freazert/prototyping/second version/schetsen/Eerste schets.jpg

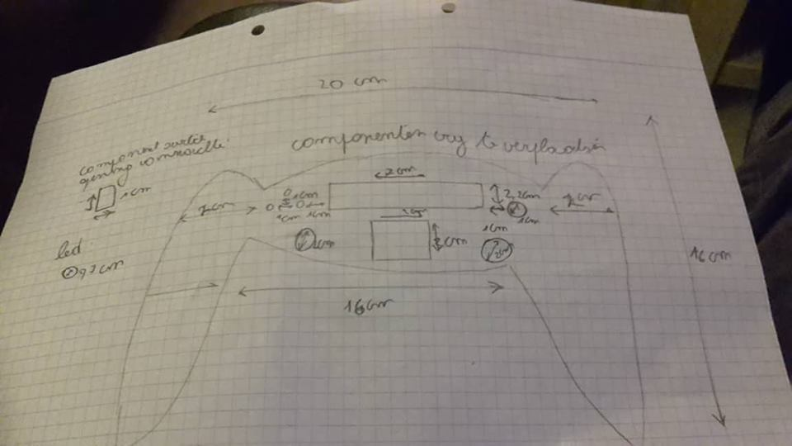
second version/schetsen/Eerste schets.jpg
