freazert/prototyping/first version/schetsen/Opmeting componenten.jpg

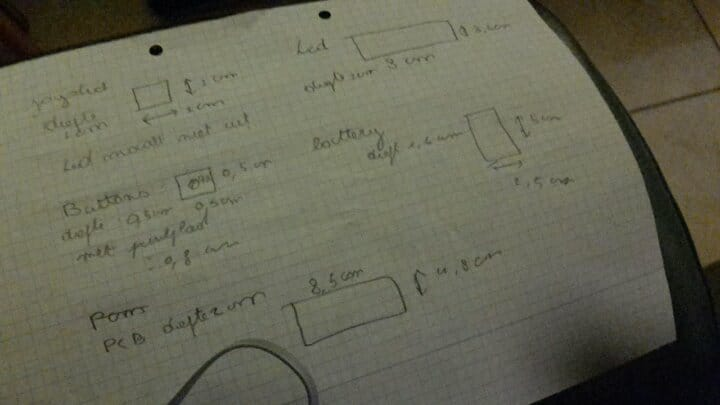
first version/schetsen/Opmeting componenten.jpg
