freazert/prototyping/first version/OpenScad/3D printen/Robot arm/Arm.stl

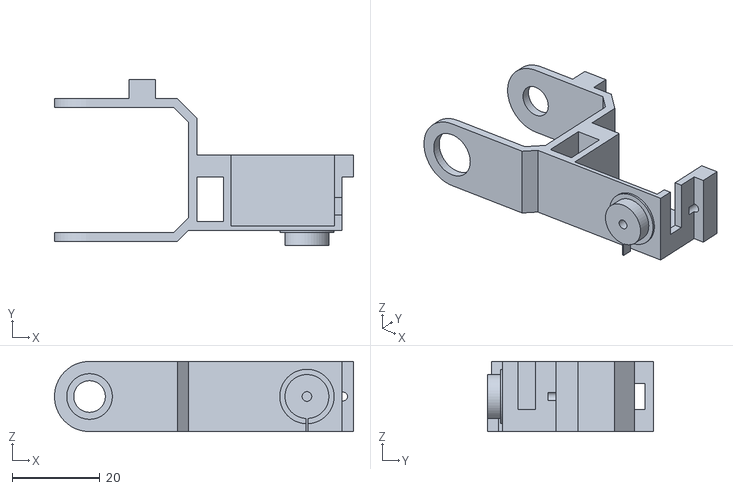
[picture p26: CAD file, 2018-10-17]
first version/OpenScad/3D printen/Robot arm/Arm.stl
68.1 x 37.9 x 16.0
