freazert/prototyping/first version/OpenScad/Lasercutting/metal/lasercutten2.dxf

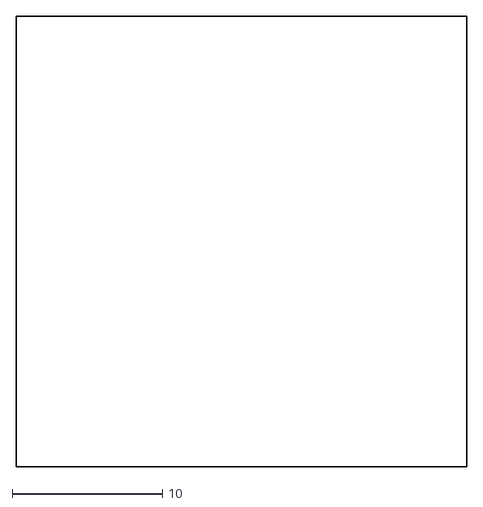
[picture p27: CAD file, 2018-10-17]
first version/OpenScad/Lasercutting/metal/lasercutten2.dxf
30.0 x 30.0
