freazert/prototyping/first version/OpenScad/Lasercutting/plexi/lasercutten2.dxf

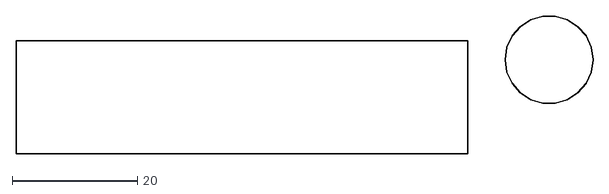
[picture p28: CAD file, 2018-10-17]
first version/OpenScad/Lasercutting/plexi/lasercutten2.dxf
92.0 x 21.9
