freazert/prototyping/first version/OpenScad/3D printen/Robot arm/ArmSpring.stl

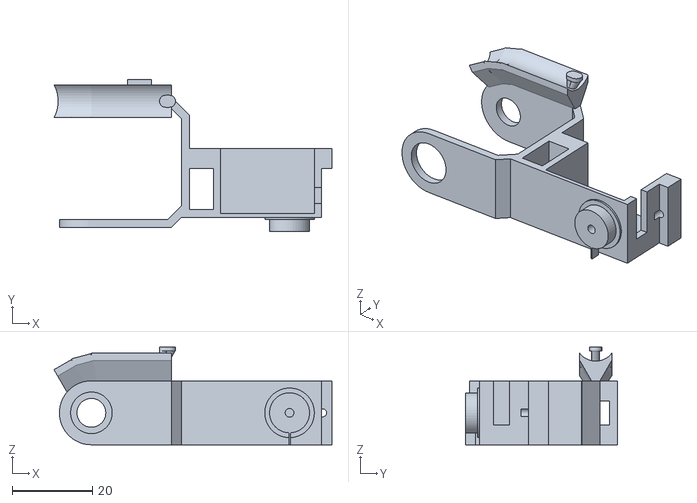
[picture p29: CAD file, 2018-10-17]
first version/OpenScad/3D printen/Robot arm/ArmSpring.stl
69.4 x 37.9 x 24.4
