freazert/prototyping/first version/OpenScad/Lasercutting/metal/lasercutten.dxf

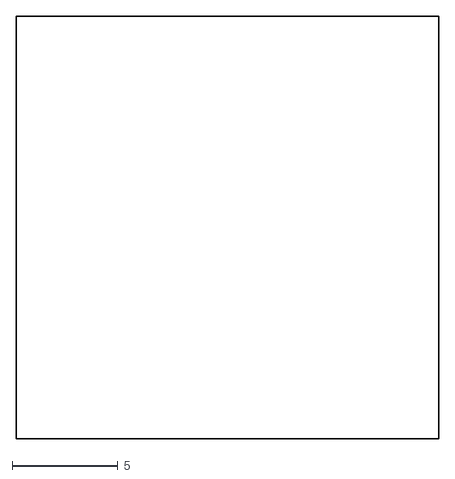
[picture p30: CAD file, 2018-10-17]
first version/OpenScad/Lasercutting/metal/lasercutten.dxf
20.0 x 20.0
