freazert/prototyping/first version/OpenScad/3D printen/Robot arm/GripperGear.stl

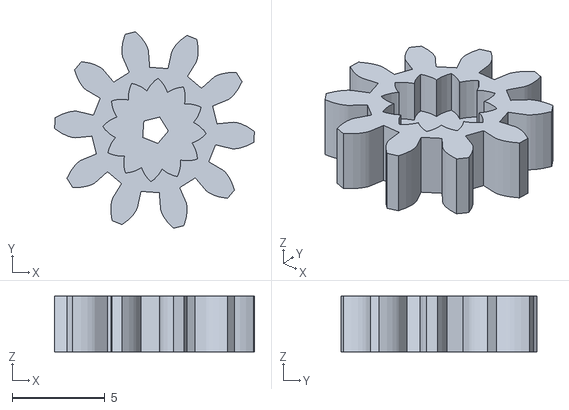
[picture p31: CAD file, 2018-10-17]
first version/OpenScad/3D printen/Robot arm/GripperGear.stl
10.8 x 10.6 x 3.00
