freazert/prototyping/first version/OpenScad/3D printen/Robot arm/GripperRack.stl

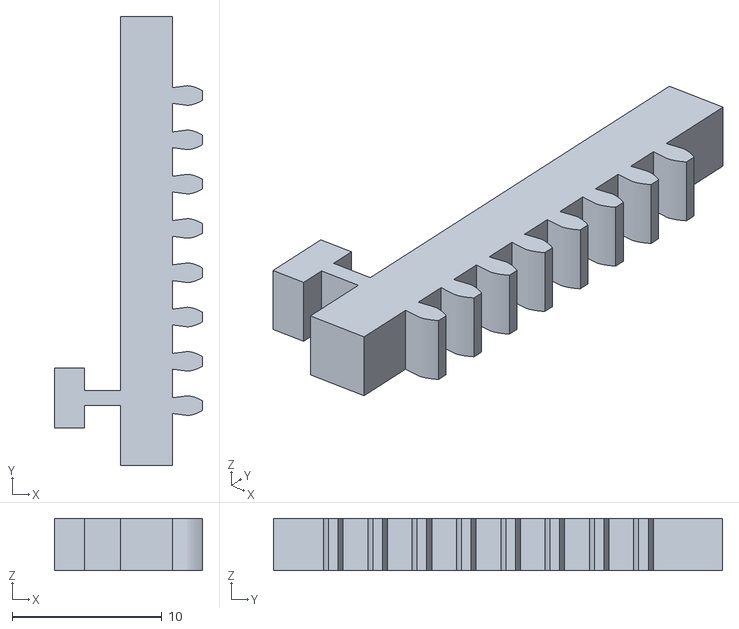
[picture p32: CAD file, 2018-10-17]
first version/OpenScad/3D printen/Robot arm/GripperRack.stl
9.89 x 30.0 x 3.50
