freazert/prototyping/first version/OpenScad/3D printen/Robot arm/Foot.stl

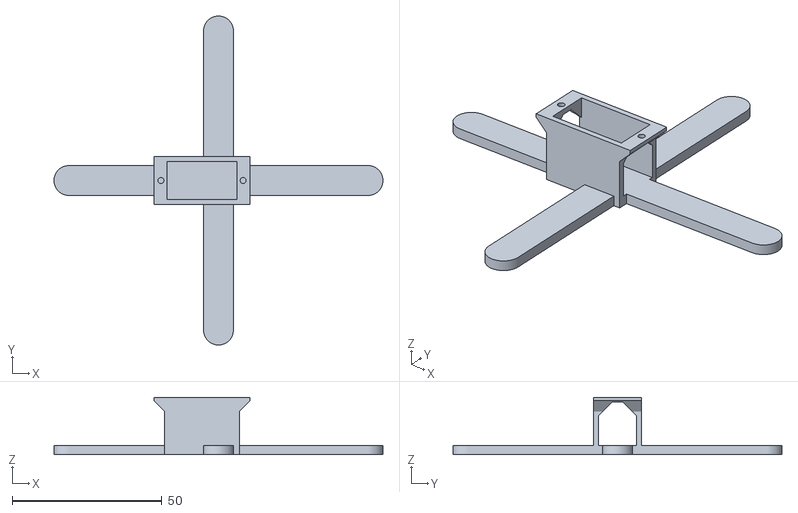
[picture p33: CAD file, 2018-10-17]
first version/OpenScad/3D printen/Robot arm/Foot.stl
110.0 x 110.0 x 19.2
