freazert/prototyping/first version/OpenScad/3D printen/Robot arm/Gripper.stl

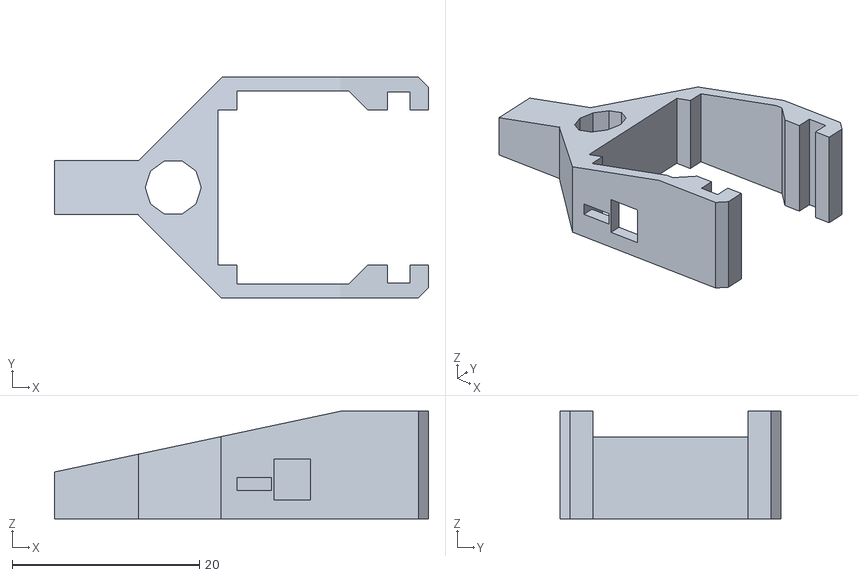
[picture p34: CAD file, 2018-10-17]
first version/OpenScad/3D printen/Robot arm/Gripper.stl
40.0 x 23.6 x 11.5
