freazert/prototyping/first version/OpenScad/3D printen/Robot arm/ArmFront.stl

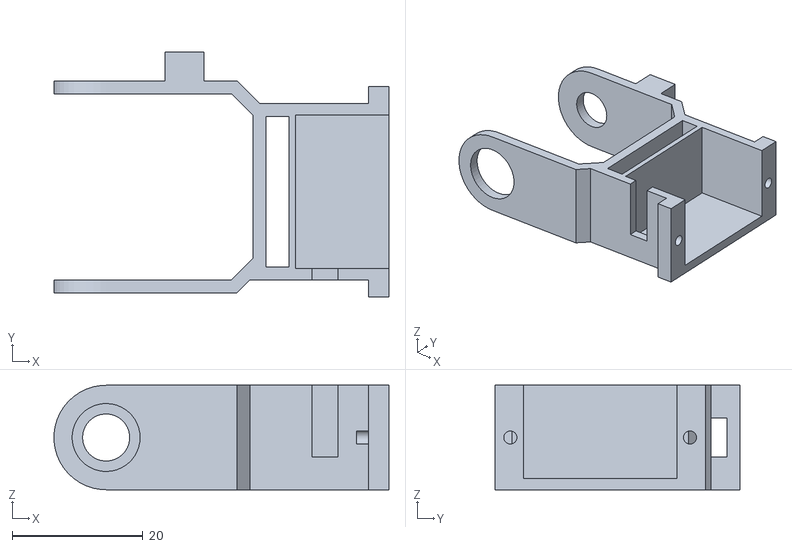
[picture p35: CAD file, 2018-10-17]
first version/OpenScad/3D printen/Robot arm/ArmFront.stl
51.3 x 37.5 x 16.0
