freazert/prototyping/first version/OpenScad/3D printen/Robot arm/FrontPlate.stl

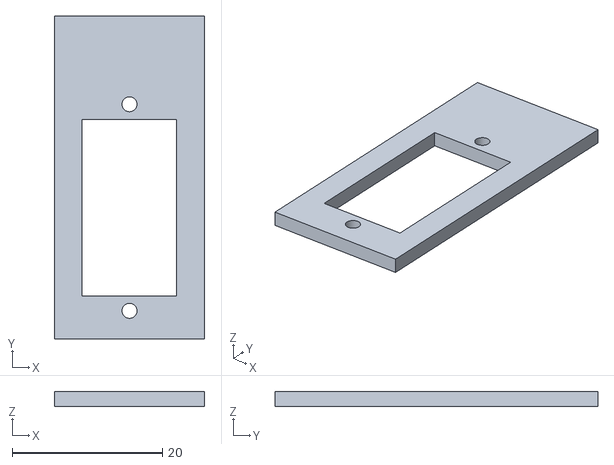
[picture p36: CAD file, 2018-10-17]
first version/OpenScad/3D printen/Robot arm/FrontPlate.stl
20.0 x 43.0 x 2.00
