freazert/prototyping/first version/OpenScad/3D printen/Robot arm/Swing.stl

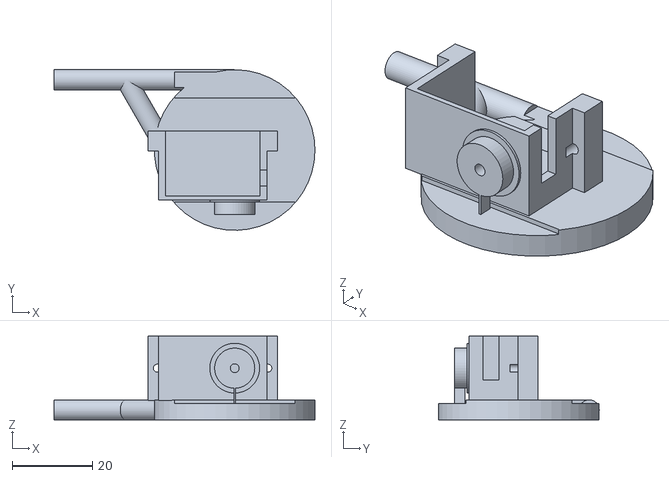
[picture p37: CAD file, 2018-10-17]
first version/OpenScad/3D printen/Robot arm/Swing.stl
65.0 x 40.0 x 20.9
