freazert/prototyping/first version/OpenScad/Lasercutting/lasercutten.scad

square([80,22]);

translate([100,15])

circle(10);

translate([130,2])
square([30,30]);
