freazert/prototyping/first version/Eagle/Robot arm.brd

## EAGLE design first version/Eagle/Robot arm.brd (2018-10-17)

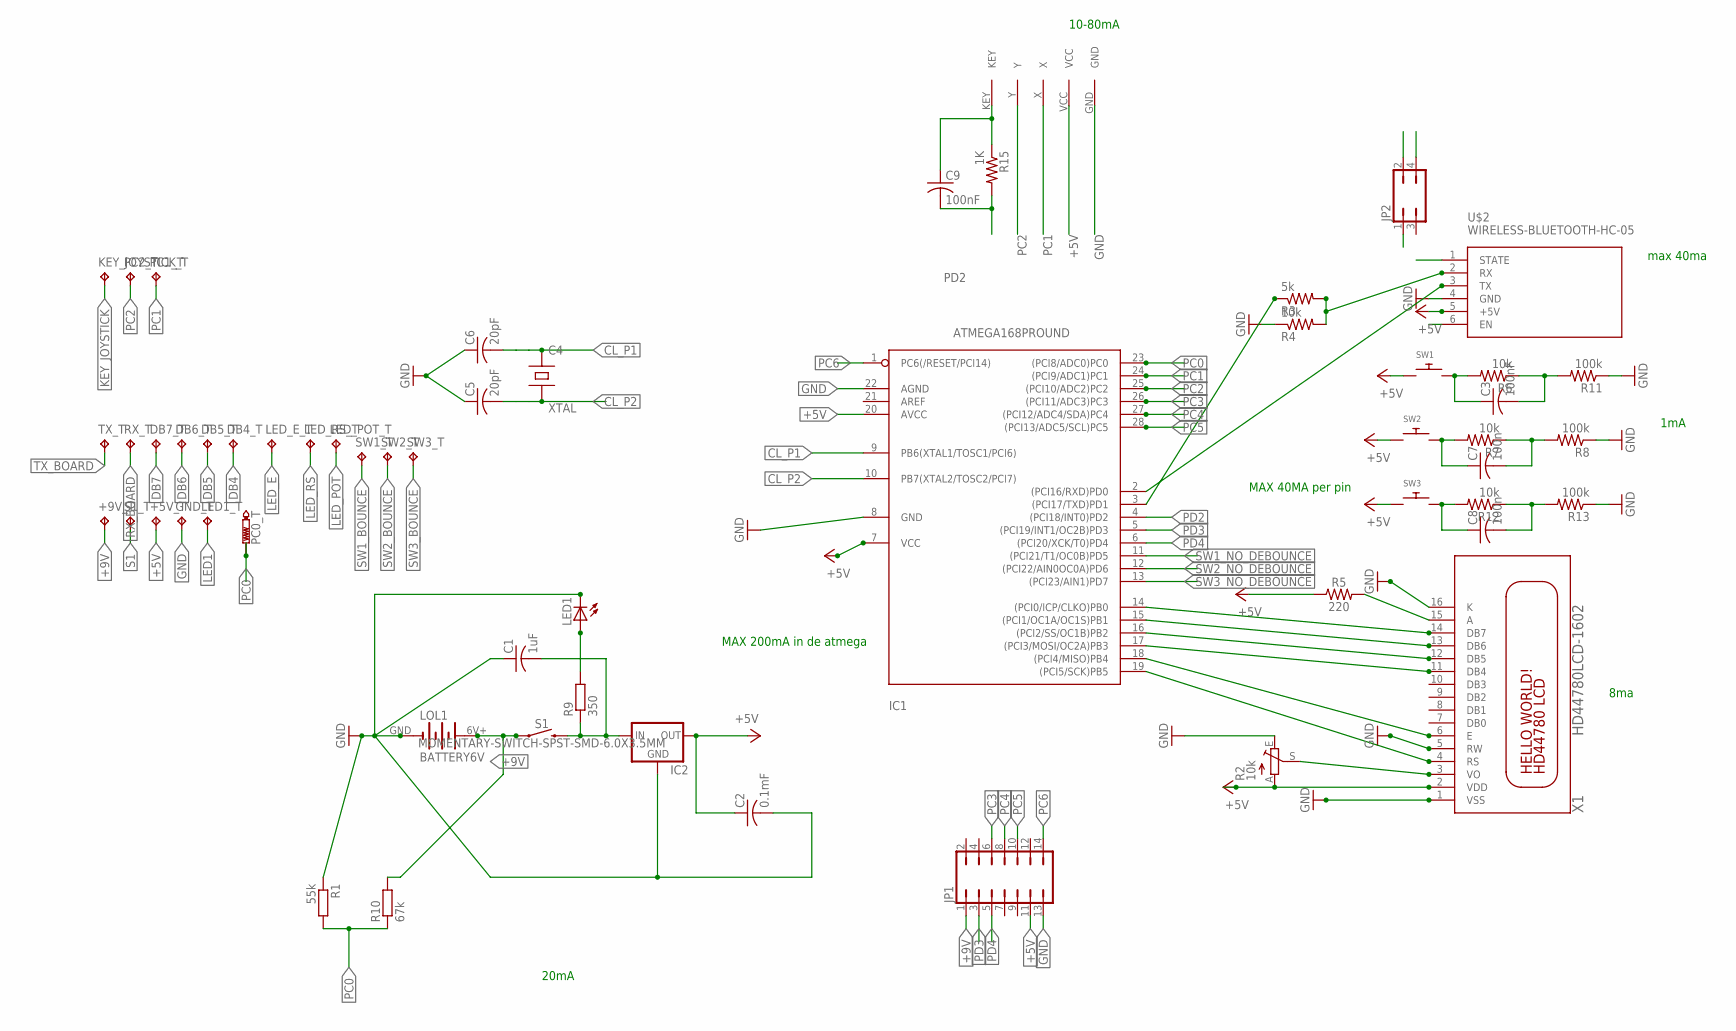
[picture p38: schematic Robot arm.sch]

Parts:
+5V_T, +9V_T: TPB1,27; B1,27
C1: 1uF; C025-025X050
C2: 0.1mF; C025-025X050
C3, C9: 100nF; C025-025X050
C4: XTAL; HC49UP
C5, C6: 20pF; C025-025X050
C7, C8: 100n; C025-025X050
DB4_T, DB5_T, DB6_T, DB7_T: TPB1,27; B1,27
GND_T: TPB1,27; B1,27
IC1: ATMEGA168PROUND; DIL28-3-ROUND
IC2: MCP1700INLINE; TO92-INLINE
JP1: JP7Q
JP2: JP2Q
KEY_JOYSTICK_T: TPB1,27; B1,27
LED1: LED_E; LED_1206
LED1_T: TPB1,27; B1,27
LED_E_T: TPB1,27; B1,27
LED_POT_T: TPB1,27; B1,27
LED_RS_T: TPB1,27; B1,27
LOL1: BATTERY6V; BATTERY6PACK
PC0_T: PTR1B1,27; B1,27
PC1_T, PC2_T: TPB1,27; B1,27
R1: 55k; R0805
R2: 10k; B25V
R3: 5k; 0204/5
R4, R6, R7, R12: 10k; 0204/5
R5: 220; 0603
R8, R11, R13: 100k; 0204/5
R9: 350; R0805
R10: 67k; R0805
R15: 1K; 0204/5
RX_T: TPB1,27; B1,27
S1: MOMENTARY-SWITCH-SPST-SMD-6.0X3.5MM; TACTILE_SWITCH_SMD_6.0X3.5MM
S1_T: TPB1,27; B1,27
SW1, SW2, SW3: SWITCH_PUSHBUTTONSOFTTOUCHSMD_SJ; PUSHBUTTON_SMD_SJ
SW1_T, SW2_T, SW3_T: TPB1,27; B1,27
TX_T: TPB1,27; B1,27
U$1: JOYSTICK
U$2: WIRELESS-BLUETOOTH-HC-05
X1: HD44780LCD-1602; LCD1602

Connections:
+5V: +5V_T.TP, C2.1, IC1.7 (VCC), IC1.20 (AVCC), IC2.3 (OUT), JP1.11, R2.A, R5.1, SW1.P$1, SW2.P$1, SW3.P$1, U$1.VCC, U$2.5 (+5V), X1.2 (VDD)
+9V: +9V_T.TP, JP1.1, LOL1.6V+ (6V), R10.2, S1.1
CL_P1: C4.1 (A), C6.2, IC1.9 (PB6(XTAL1/TOSC1/PCI6))
CL_P2: C4.2 (B), C5.2, IC1.10 (PB7(XTAL2/TOSC2/PCI7))
DB4: DB4_T.TP, IC1.17 ((PCI3/MOSI/OC2A)PB3), X1.11 (DB4)
DB5: DB5_T.TP, IC1.16 ((PCI2/SS/OC1B)PB2), X1.12 (DB5)
DB6: DB6_T.TP, IC1.15 ((PCI1/OC1A/OC1S)PB1), X1.13 (DB6)
DB7: DB7_T.TP, IC1.14 ((PCI0/ICP/CLKO)PB0), X1.14 (DB7)
EN: JP2.4, U$2.6 (EN)
GND: C1.1, C2.2, C5.1, C6.1, GND_T.TP, IC1.8 (GND), IC1.22 (AGND), IC2.1 (GND), JP1.13, JP2.1, LED1.C, LOL1.GND, R1.1, R2.E, R4.1, R8.1, R11.1, R13.1, U$1.GND, U$2.4 (GND), X1.1 (VSS), X1.5 (RW), X1.16 (K)
KEY_JOYSTICK: C9.1, KEY_JOYSTICK_T.TP, R15.1, U$1.KEY
LED1: LED1.A, LED1_T.TP, R9.2
LED_E: IC1.18 ((PCI4/MISO)PB4), LED_E_T.TP, X1.6 (E)
LED_POT: LED_POT_T.TP, R2.S, X1.3 (VO)
LED_RS: IC1.19 ((PCI5/SCK)PB5), LED_RS_T.TP, X1.4 (RS)
unnamed: R5.2, X1.15 (A)
PC0: IC1.23 ((PCI8/ADC0)PC0), PC0_T.TP, R1.2, R10.1
PC1: IC1.24 ((PCI9/ADC1)PC1), PC1_T.TP, U$1.X
PC2: IC1.25 ((PCI10/ADC2)PC2), PC2_T.TP, U$1.Y
PC3: IC1.26 ((PCI11/ADC3)PC3), JP1.6
PC4: IC1.27 ((PCI12/ADC4/SDA)PC4), JP1.8
PC5: IC1.28 ((PCI13/ADC5/SCL)PC5), JP1.10
PC6: IC1.1 (PC6(/RESET/PCI14)), JP1.14
PD2: C9.2, IC1.4 ((PCI18/INT0)PD2), R15.2
PD3: IC1.5 ((PCI19/INT1/OC2B)PD3), JP1.3
PD4: IC1.6 ((PCI20/XCK/T0)PD4), JP1.5
RX: R3.2, R4.2, U$2.2 (RX)
RX_BOARD: IC1.2 ((PCI16/RXD)PD0), RX_T.TP, U$2.3 (TX)
S1: C1.2, IC2.2 (IN), R9.1, S1.2, S1_T.TP
STATE: JP2.2, U$2.1 (STATE)
SW1_BOUNCE: C3.1, R6.2, SW1.P$2, SW1_T.TP
SW1_NO_DEBOUNCE: C3.2, IC1.11 ((PCI21/T1/OC0B)PD5), R6.1, R11.2
SW2_BOUNCE: C7.1, R7.2, SW2.P$2, SW2_T.TP
SW2_NO_DEBOUNCE: C7.2, IC1.12 ((PCI22/AIN0OC0A)PD6), R7.1, R8.2
SW3_BOUNCE: C8.1, R12.2, SW3.P$2, SW3_T.TP
SW3_NO_DEBOUNCE: C8.2, IC1.13 ((PCI23/AIN1)PD7), R12.1, R13.2
TX_BOARD: IC1.3 ((PCI17/TXD)PD1), R3.1, TX_T.TP

Notes on the sheet:
max 40ma
8ma
1mA
10-80mA
20mA
MAX 40MA per pin
MAX 200mA in de atmega

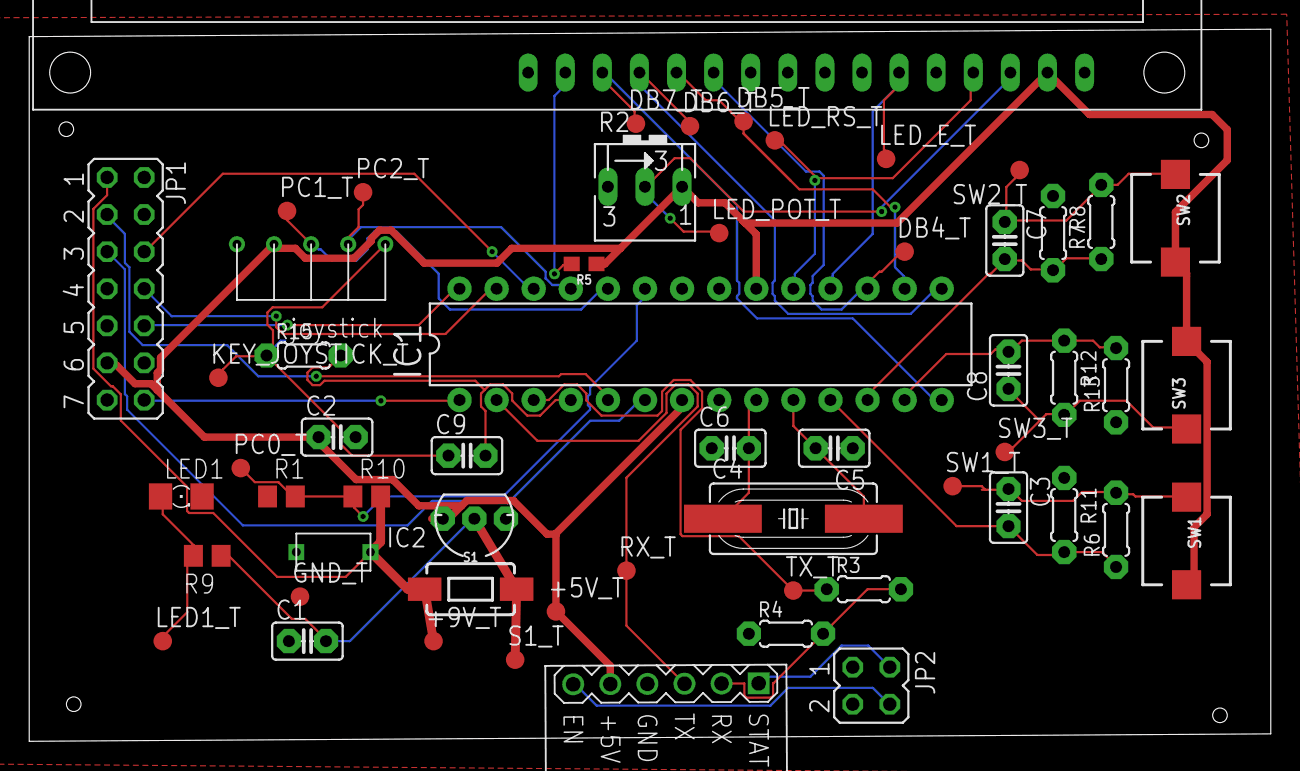
[picture p39: board Robot arm.brd from above]

Board: 2 copper layers, 85.0 x 48.8 mm, 57 parts (0 on the bottom side), 37 nets.
